ultrazohm/uz_per_skai3_lv_48v_410a/Dokumentation/IMSA-9890S-xxZ925(Z26-GT2).pdf

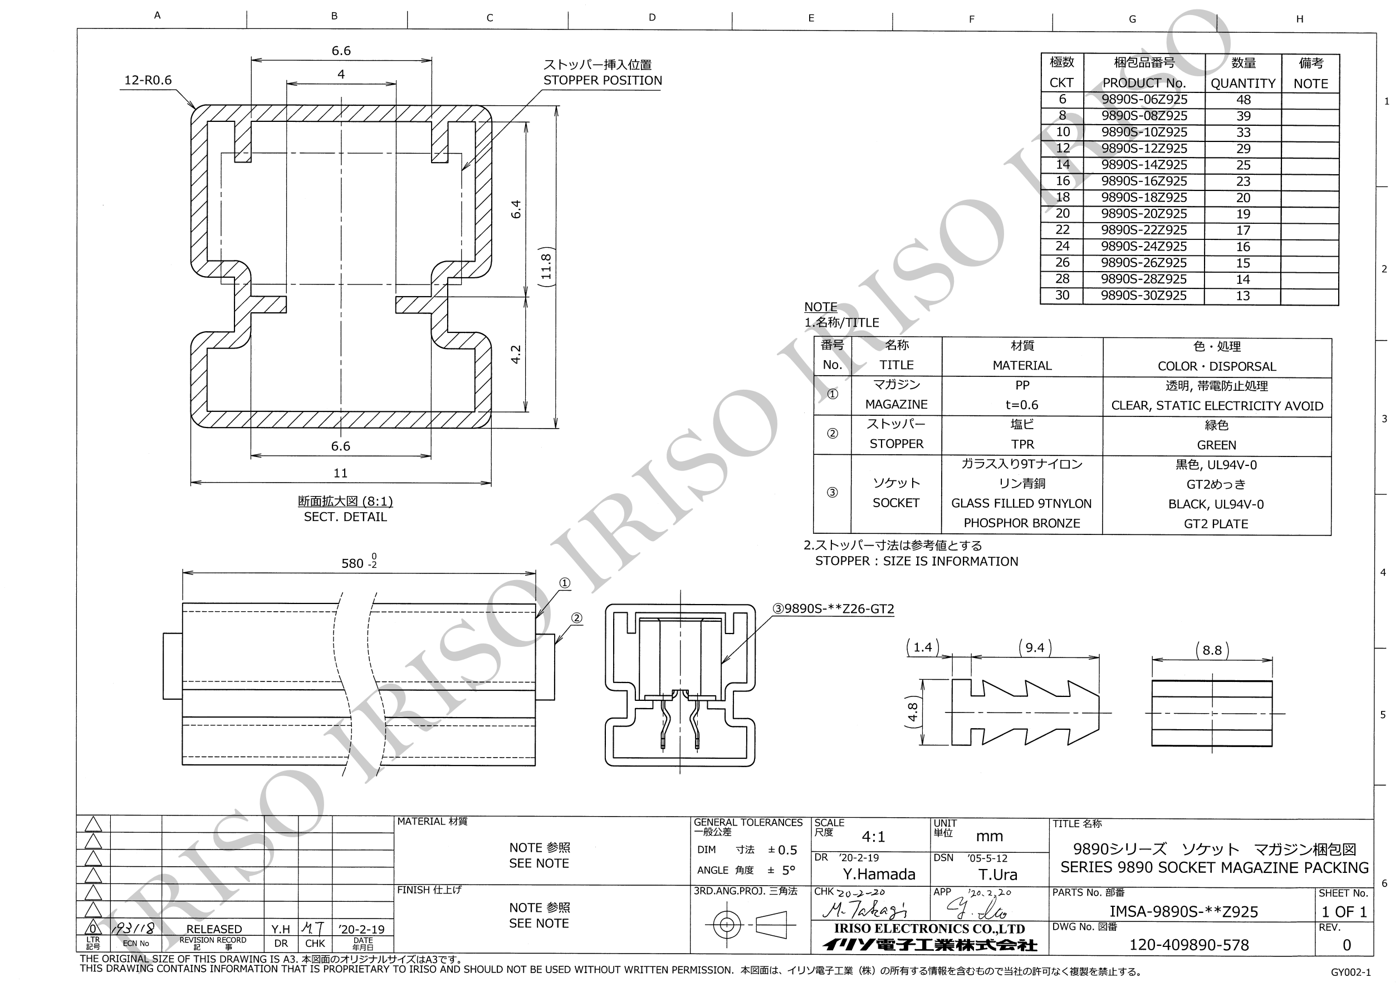
[picture p1: page 1]

IRISO IRISO IRISO IRISO IRISO

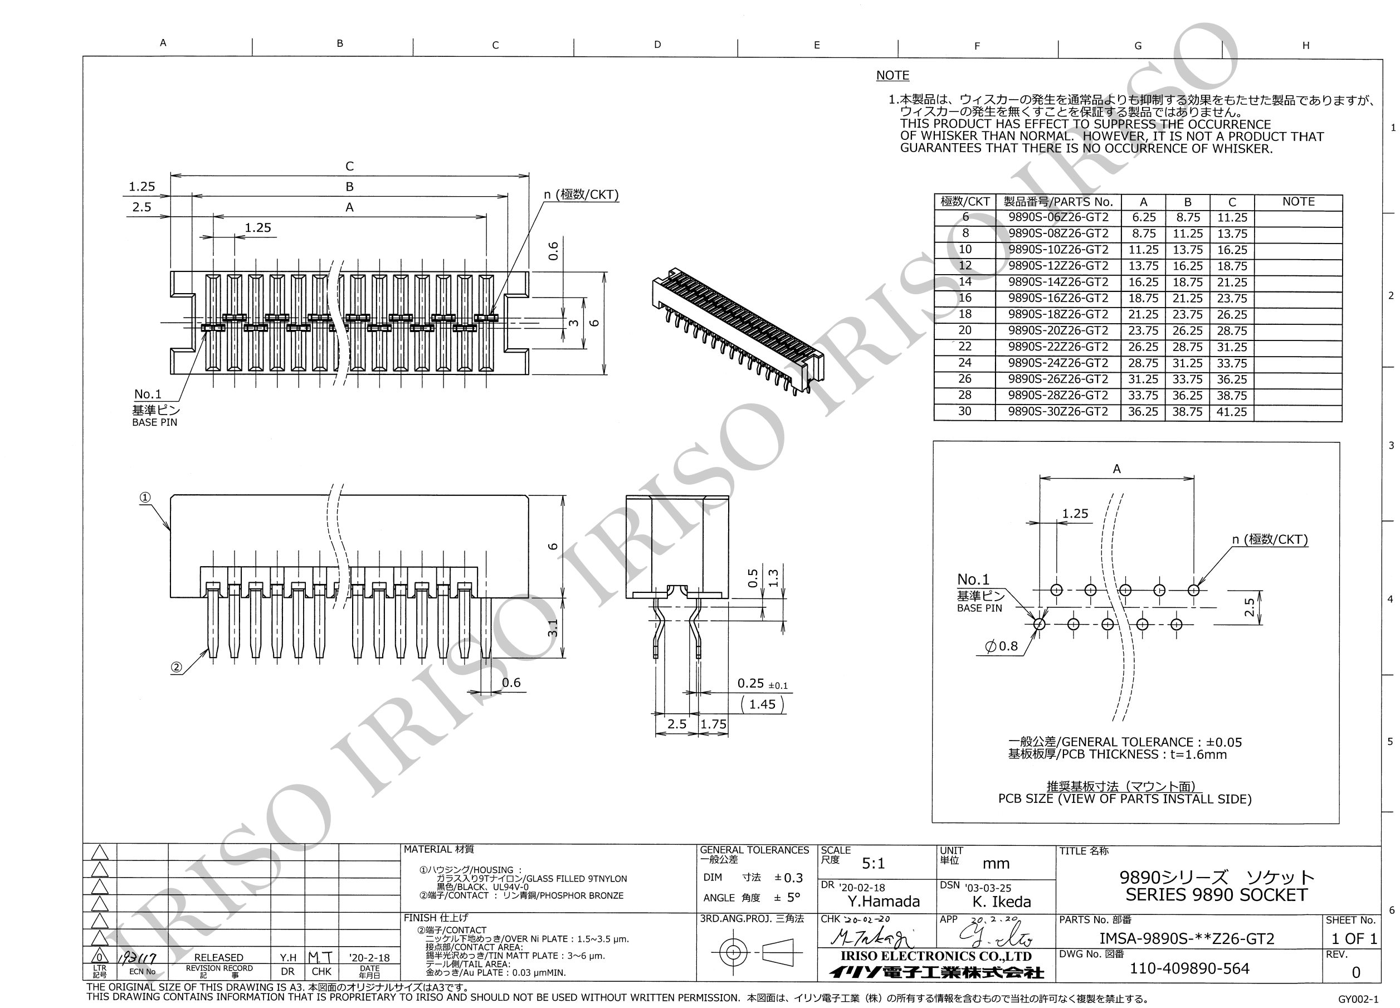
[picture p2: page 2]

IRISO IRISO IRISO IRISO IRISO
