ultrazohm/uz_per_skai3_lv_48v_410a/Altium/Project Outputs for UZ_PER_SKAI3_LV_48V_410A/Rev01/BOM/BOM_JLC-UZ_PER_SKAI3_LV_48V_410A(NoTerminationsFitted).xlsx

Quantity | Comment | Designator | Manufacturer | Value | Description | Footprint | Voltage | Dielectric | Manufacturer Part Number | LCSC Part Number
25 | 0.1 µF | C1, C2, C6, C8, C10, C11, C12, C13, C19, C20, C21, C22, C29A, C29B, C29C, C30A, C30B, C30C, C31A, C31B, C31C, C32A, C32B, C32C, C38 | KEMET | 0.1 µF | Capacitor 0603, 50 VDC, 0.1 µF, X7R | C_0603 |  |  | C0603X104K5RAC7411 | C14663
6 | 10 uF | C3, C4, C5, C7, C9, C41 | Samsung Electro-Mechanics | 10 uF | 50V 10uF X7R ±10% 1206 Multilayer Ceramic Capacitors MLCC - SMD/SMT ROHS | C_1206 |  |  | CL31B106KBHNNNE | C89632
1 | 100 pF | C14 | Samsung Electro-Mechanics | 100 pF | 50V 100pF C0G ±5% 0603 Multilayer Ceramic Capacitors MLCC - SMD/SMT ROHS | C_0603 |  |  | CL10C101JB8NNNC | C14858
6 | 22 µF | C15, C16, C17, C18, C39, C40 | muRata | 22 µF | Capacitor 0805, 25 VDC, 22 µF, X5R | C_0805 |  |  | GRT21BR61E226ME13L | C398931
16 | 56 pF | C23, C24, C25, C26, C33A, C33B, C33C, C34A, C34B, C34C, C35A, C35B, C35C, C36A, C36B, C36C | Samsung Electro-Mechanics | 56 pF | Capacitor 0603, 50 VDC, 56 pF, C0G | C_0603 |  |  | CL10C560JB8NNNC | C39148
4 | 12 nF | C27, C37A, C37B, C37C | Yageo | 12 nF | Capacitor 0603, 16 VDC, 12 nF, X7R | C_0603 |  |  | CC0603KRX7R7BB123 | C519427
1 | 1 µF | C28 | KEMET | 1 µF | Capacitor 1206, 50 VDC, 1 µF, X7R | C_1206 |  |  | C1206X105K5RECAUTO | C107185
4 | 150060GS84000 | D1, D2, D3, D4 | Wuerth Elektronik |  | WL-SMCW SMD Mono-color Chip LED Waterclear Green | WL-SMCW_0603 |  |  | 150060GS84000
1 | 0154.500DR | F1 | Littlefuse | 500 mA | Fuse OMNI BLOK 154 | Littlefuse_154 |  |  | 0154.500DR
2 | RJHSE3M80 | J1, J2 | Amphenol |  | CAT5, RJ45 Connector, 1 port, vertical | RJHSE3M80 |  |  | RJHSE3M80 | C3179193
1 | FCR7350B, PCB mount 4mm jack, BLACK | J3 | Cliff | PCB mount 4mm jack, Black FCR7350B, 1000V, 24A | FCR7350B, 1000V, 24A, BLACK | FCR7350 |  |  | FCR7350B | C7437327
1 | FCR7350R, PCB mount 4mm jack, RED | J4 | Cliff | PCB mount 4mm jack, Red FCR7350R, 1000V, 24A | FCR7350B, 1000V, 24A, RED | FCR7350 |  |  | FCR7350R | C7437326
4 | LQM31PN4R7M00L | L1, L2, L3, L4 | Murata | 4.7 uH | Power Inductors - SMD 4.7 UH 20% | IND 1206_3216 |  |  | LQM31PN4R7M00L | C162588
8 | LQM18DN6R8M70L | L5, L6, L7A, L7B, L7C, L8A, L8B, L8C | Murata | 6.8uH | 6.8µH, 120mA, 0603, 740mOhm, 20% | INDC1608X95N |  |  | LQM18DN6R8M70L | C1881372
10 | 0R | R1, R2, R30, R42, R43, R44, R45, R46, R47, R48 | YAGEO | 0R | SMD resistor E24 series | RES 0603_1608 |  |  | RC0603JR-070RL | C21189
1 | 18k | R11 | KOA Speer | 18k | SMD resistor E24 series | RES 0603_1608 |  |  | RK73B1JTTD183J | C171726
2 | 10k | R12, R17 | TE Connectivity | 10k | SMD resistor 0.1%, 10ppm | RES 0603_1608 |  |  | RQ73C1J10KBTD | C95204
2 | 305k | R13, R14 | KOA Speer | 305k | SMD resistor 0.1% | RES 0603_1608 |  |  | RN73R1JTTD3053B25 | C2507039
1 | 3k9 | R15 | YAGEO | 3k9 | SMD resistor E24 series | RES 0603_1608 |  |  | RT0603FRE073K9L | C863790
1 | 2k49 | R16 | Yageo | 2k49 | SMD resistor 1% | RES 0603_1608 |  |  | RC0603FR-072K49L | C108190
16 | 49R9 | R18, R19, R20, R21, R31A, R31B, R31C, R32A, R32B, R32C, R33A, R33B, R33C, R34A, R34B, R34C | KOA Speer | 49R9 | SMD resistor 1% | RES 0603_1608 |  |  | RK73H1JTTD49R9F | C160046
10 | 1k | R22, R23, R26, R27, R39A, R39B, R39C, R40A, R40B, R40C | IRC / TT Electronics | 1k | SMD resistor 0.1% | RES 0603_1608 |  |  | PCF-W0603LF-03-1001-B-P-LT | C110776
12 | 12.3k | R24, R25, R28, R37A, R37B, R37C, R38A, R38B, R38C, R41A, R41B, R41C | YAGEO | 12.3k | SMD resistor E24 series 12 kOhms 100mW 0603 1% | RES 0603_1608 |  |  | RT0603BRD0712K3L | C861101
9 | 5.05k | R29, R35A, R35B, R35C, R36A, R36B, R36C, R49, R50 | Vishay | 5.05k | SMD resistor 0.1% | RES 0603_1608 |  |  | TNPW06035K05BEEA | C1693738
1 | Serial # | Serial | PCB Manufacturer |  | Field to put in a serial number | SERIAL |  |  | Serial Number
2 | DS34LV86TM/NOPB | U1, U2 | Texas Instruments |  | 3V Enhanced CMOS Quad Differential Line Receiver, 16-pin Narrow SOIC, Pb-Free | TI_D-R-PDSO-G16_N |  |  | DS34LV86TM/NOPB | C181570
1 | AP63205WU-7 | U3 | Diodes Incorporate |  | Switching Voltage Regulators DCDC Conv HV Buck TSOT26 T&R 3K | TSOT26-6 |  |  | AP63205WU-7
1 | AP63200WU-7 | U4 | Diodes Incorporate |  | Switching Voltage Regulators DCDC Conv HV Buck TSOT26 T&R 3K | TSOT26-6 |  |  | AP63200WU-7
1 | AP63203WU-7 | U5 | Diodes Incorporate |  | Switching Voltage Regulators DCDC Conv HV Buck TSOT26 T&R 3K | TSOT26-6 |  |  | AP63203WU-7 | C780769
8 | ADA4940-1ARZ-R7 | U6, U7, U8A, U8B, U8C, U9A, U9B, U9C | Analog Devices |  | Fully Differential Amplifier, Ultralow-Power,Low Distortion, 260-MHz | SOT127P600X175-8N |  |  | ADA4940-1ARZ-R7 | C730049
1 | DS26C31TMX/NOPB | U10 | Texas Instruments |  | CMOS Quad Tri-State Differential Line Drivers, 16-pin Narrow SOIC, Pb-Free | TI_D-R-PDSO-G16_N |  |  | DS26C31TMX/NOPB | C132085
1 | IPL1-115-01-L-D-K | X1 | SAMTEC |  | 2.54 mm Double Row Terminal Assembly | IPL1-115-01-YYY-D-K |  |  | IPL1-115-01-L-D-K
2 | IMSA-9890S-20K-GT2 | X21, X22 | IRISO |  | Board to Board Connector | IMSA-9890S-20Z924 |  |  | IMSA-9890S-20K-GT2
