ultrazohm/uz_per_skai3_lv_48v_410a/Dokumentation/9890S-20K.STEP

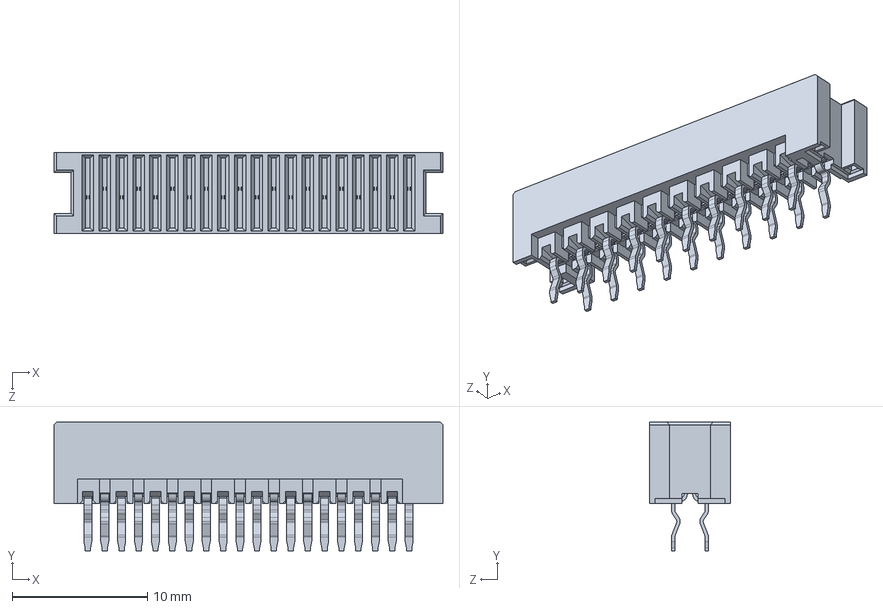
[picture p3: CAD file, 2024-04-08]
Dokumentation/9890S-20K.STEP
28.8 x 9.50 x 6.00 mm
