ultrazohm/uz_per_skai3_lv_48v_410a/Altium/Project Outputs for UZ_PER_SKAI3_LV_48V_410A/Rev01/SCH_UZ_PER_SKAI3_LV_48V_410A_Differential_Input_Rev01.PDF

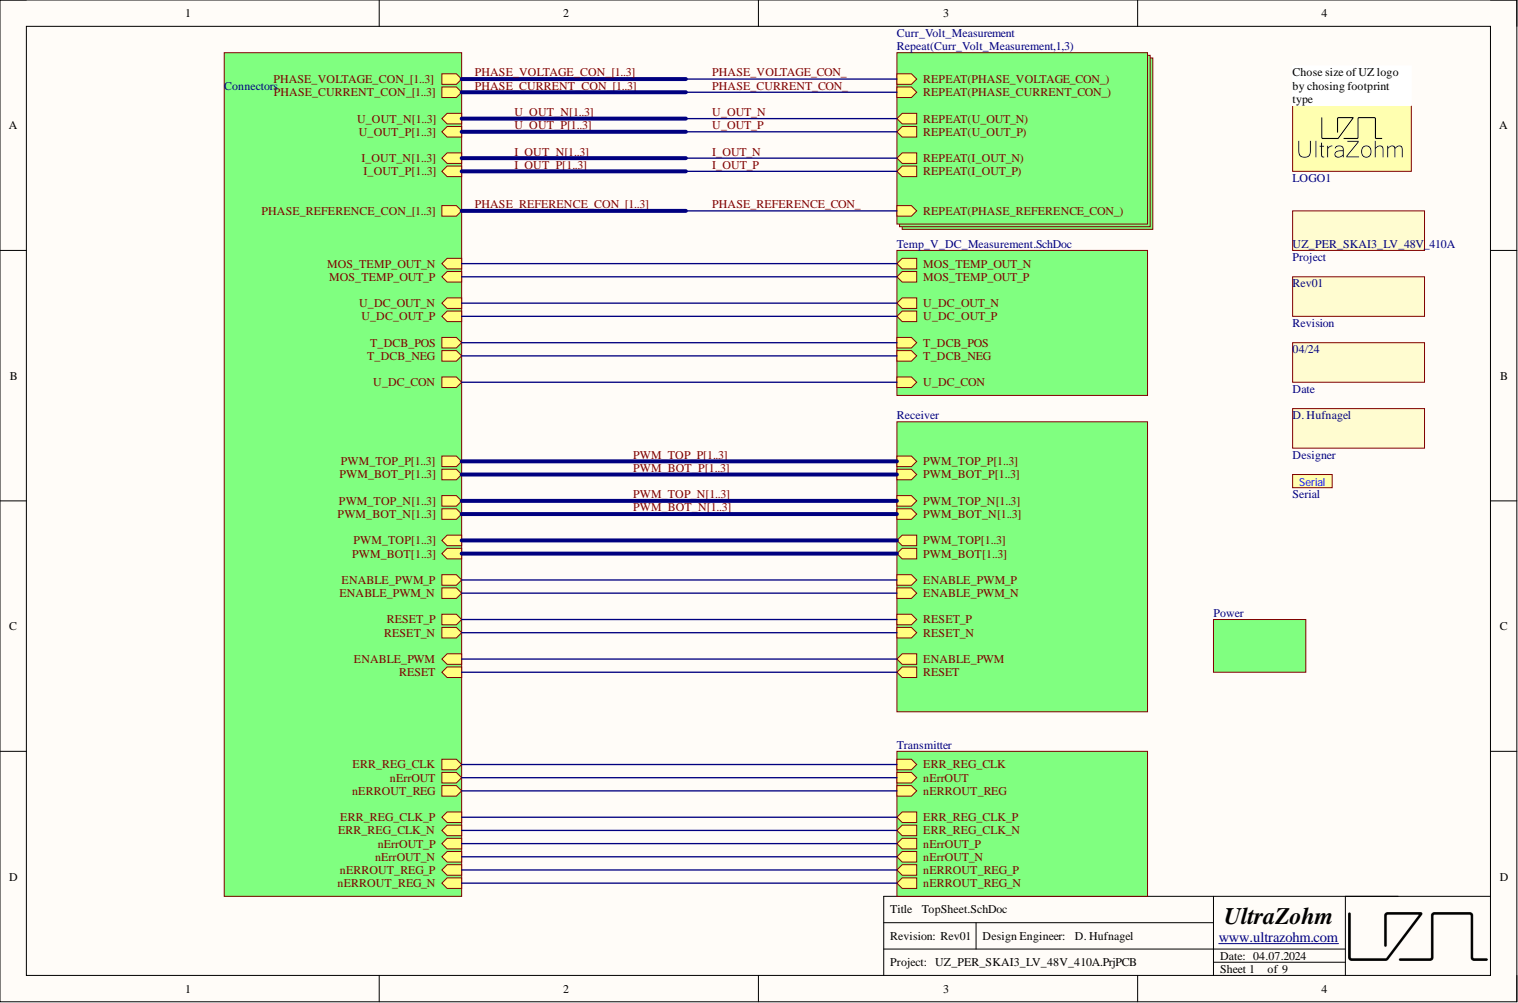
[picture p4: page 1]

Chose size of UZ logo
by chosing footprint
type

Revision:

Date: 04.07.2024

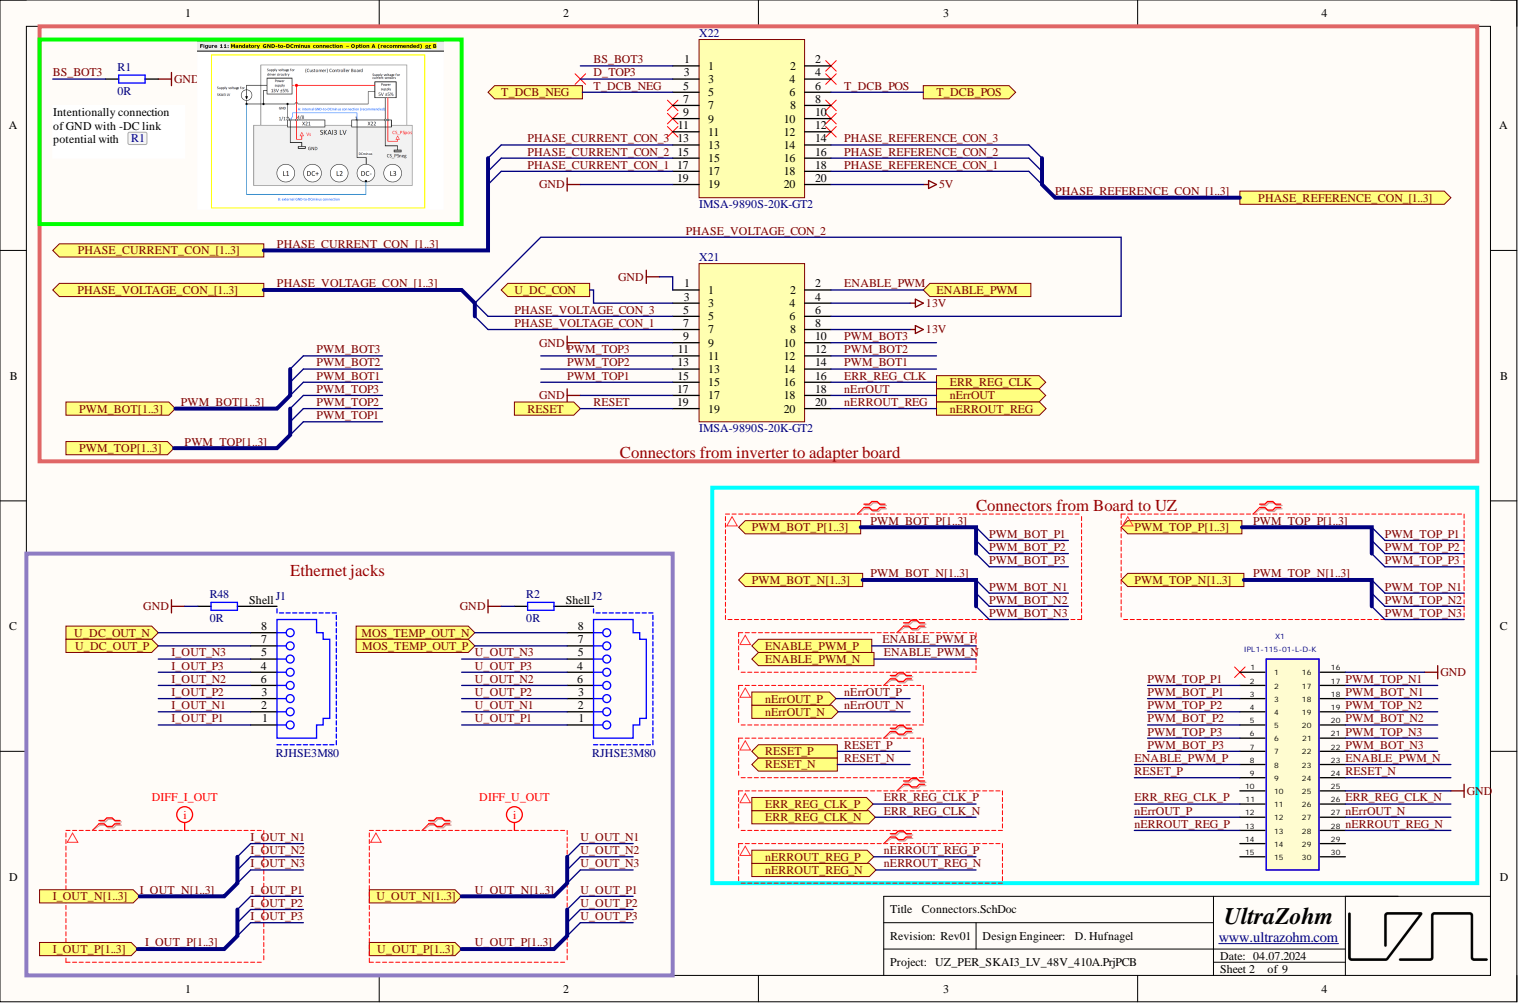
[picture p5: page 2]

Intentionally connection
of GND with -DC link
potential with R1

Connectors from inverter to adapter board

Connectors from Board to UZ

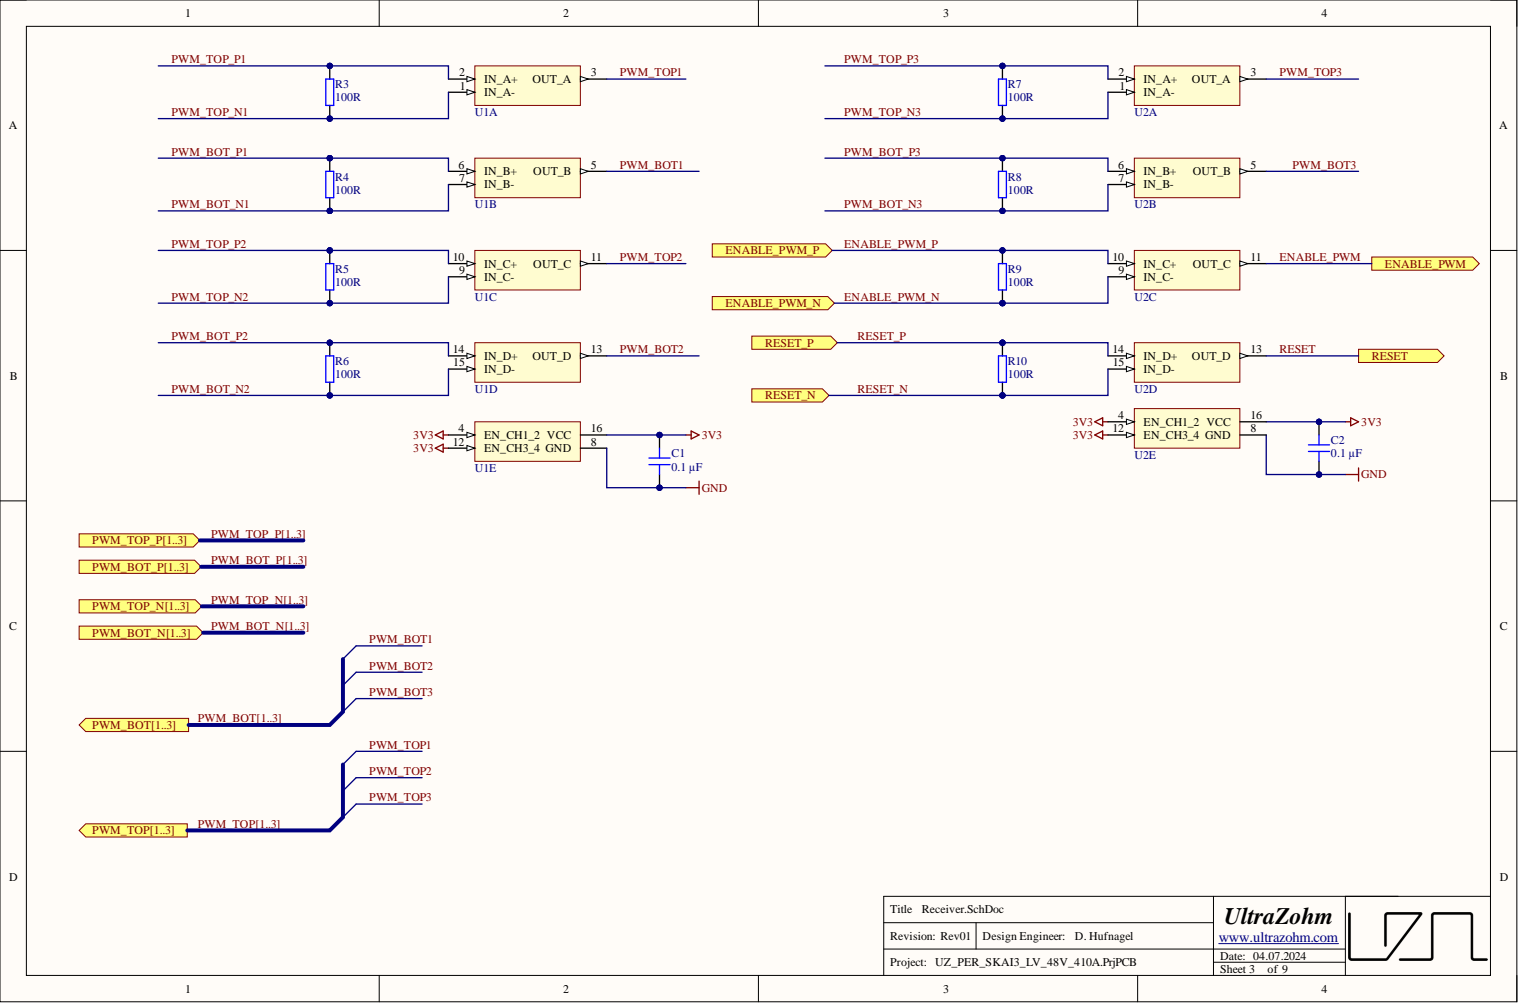
[picture p6: page 3]

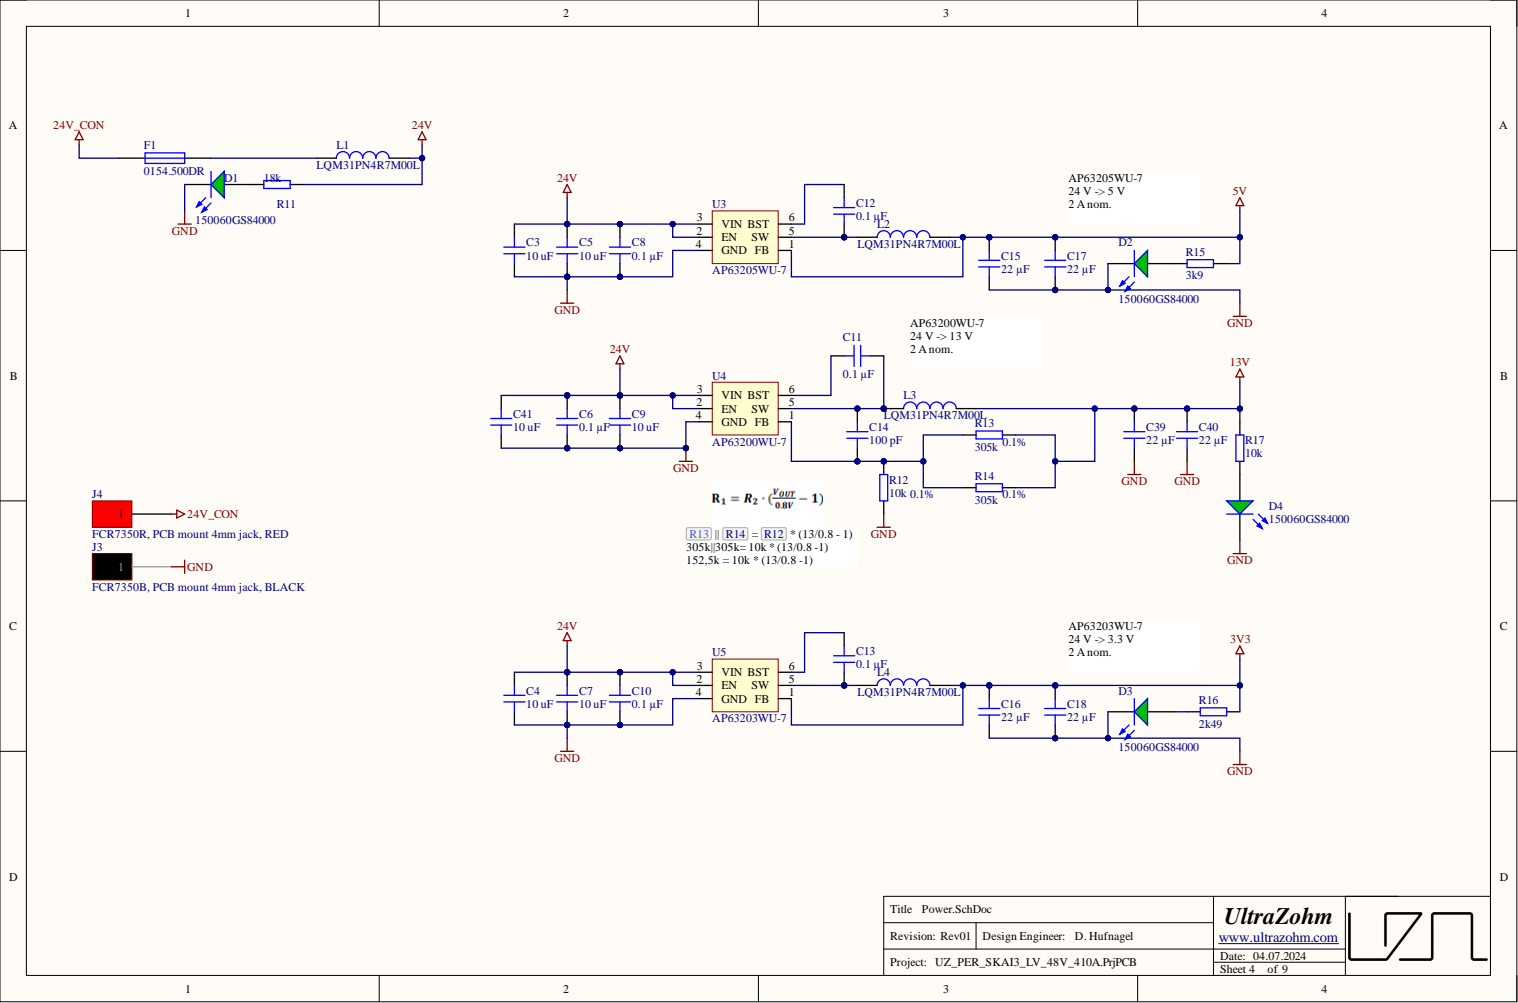
[picture p7: page 4]

Rev i s i o n :

Dat e : .

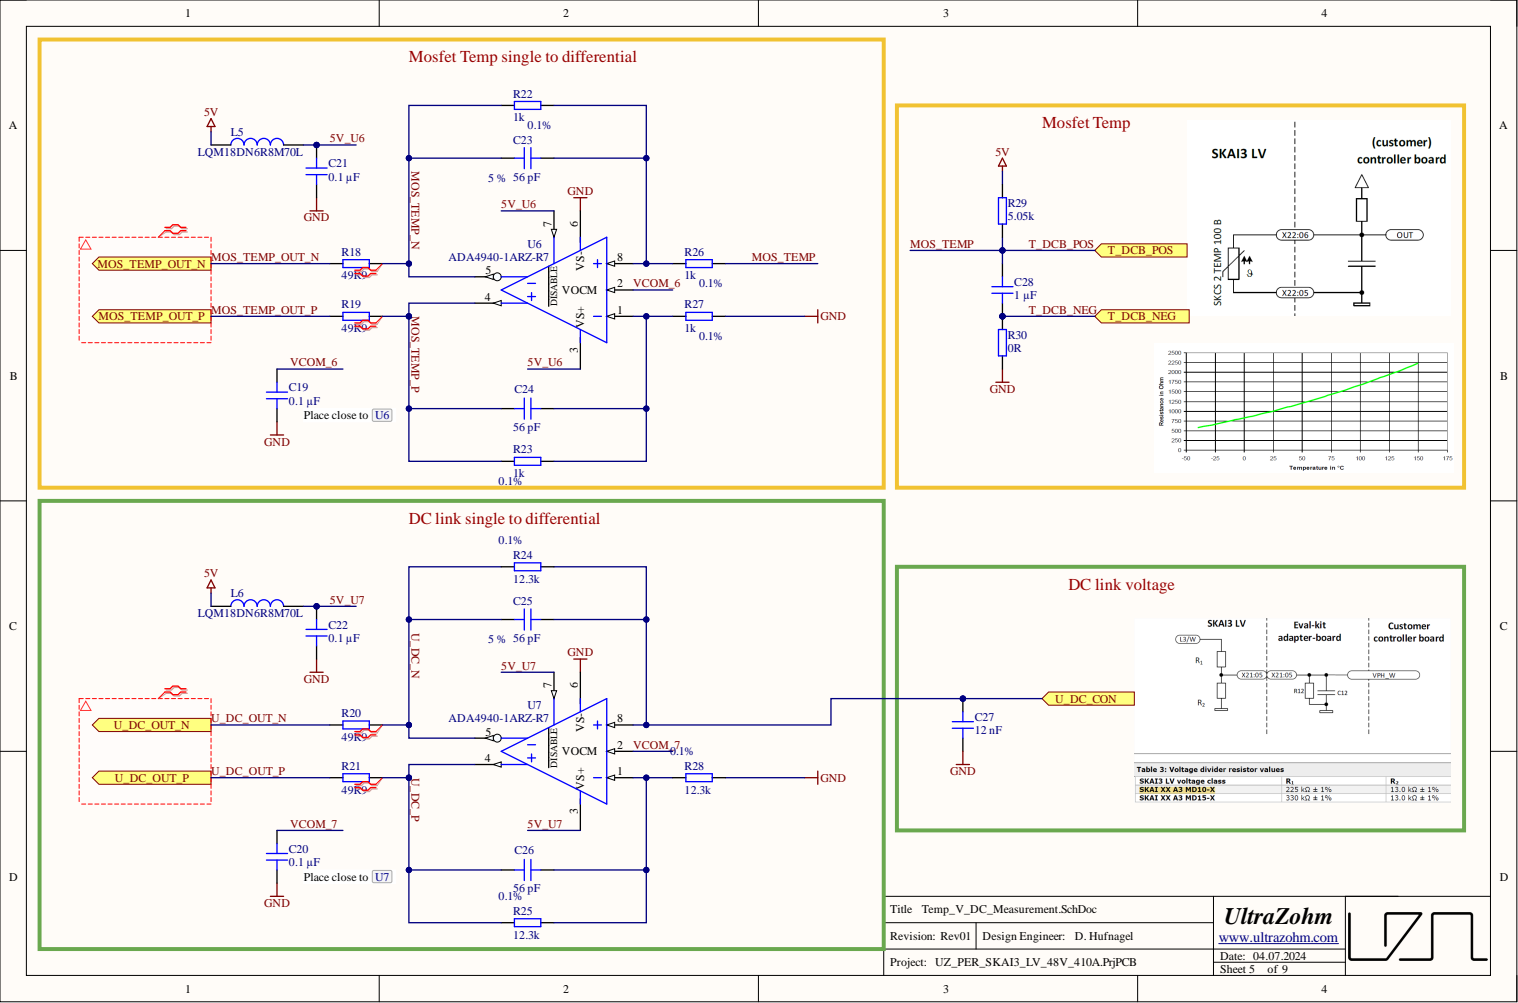
[picture p8: page 5]

Mosfet Temp single to differential

DC link single to differential

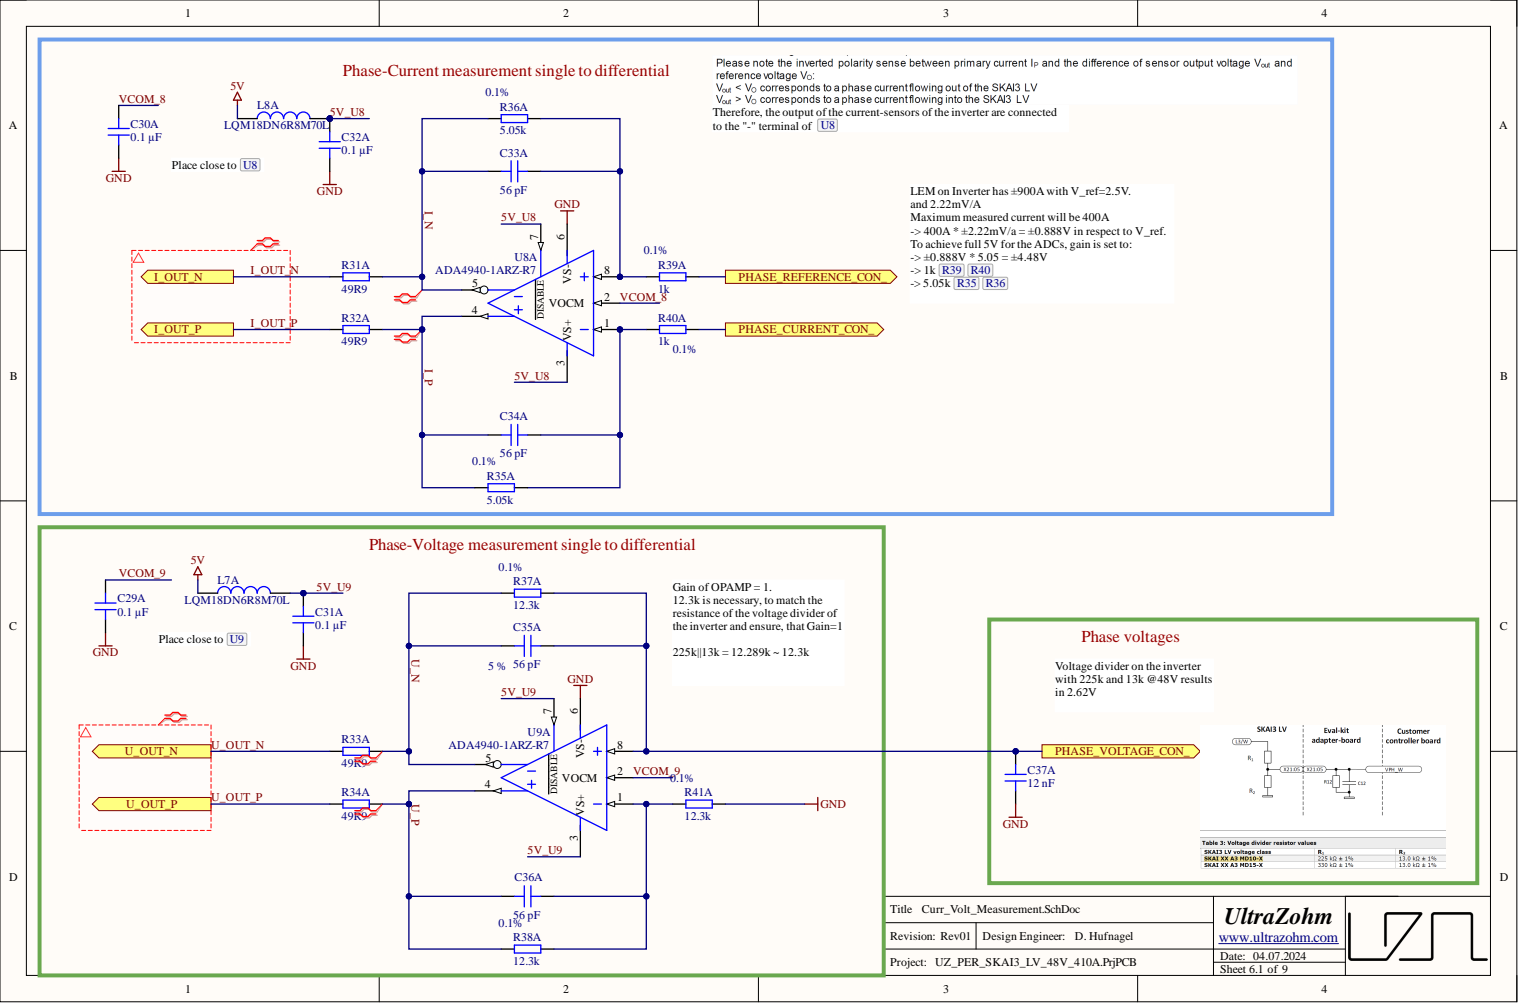
[picture p9: page 6]

Phase-Current measurementsingle to differential

Therefore, the output of the current-sensors of the inverter are connected
to the "-" terminal of U8

LEM on Inverter has ±900A with V_ref=2.5V.
and 2.22mV/A
Maximum measured current will be 400A
-> 400A * ±2.22mV/a = ±0.888V in respect to V_ref.
To achieve full 5V for the ADCs, gain is set to:

Phase-Voltage measurementsingle to differential

Gain of OPAMP = 1.
12.3k is necessary, to match the
resistance of the voltage divider of
the inverter and ensure, that Gain=1

Voltage divider on the inverter
with 225k and 13k @48V results

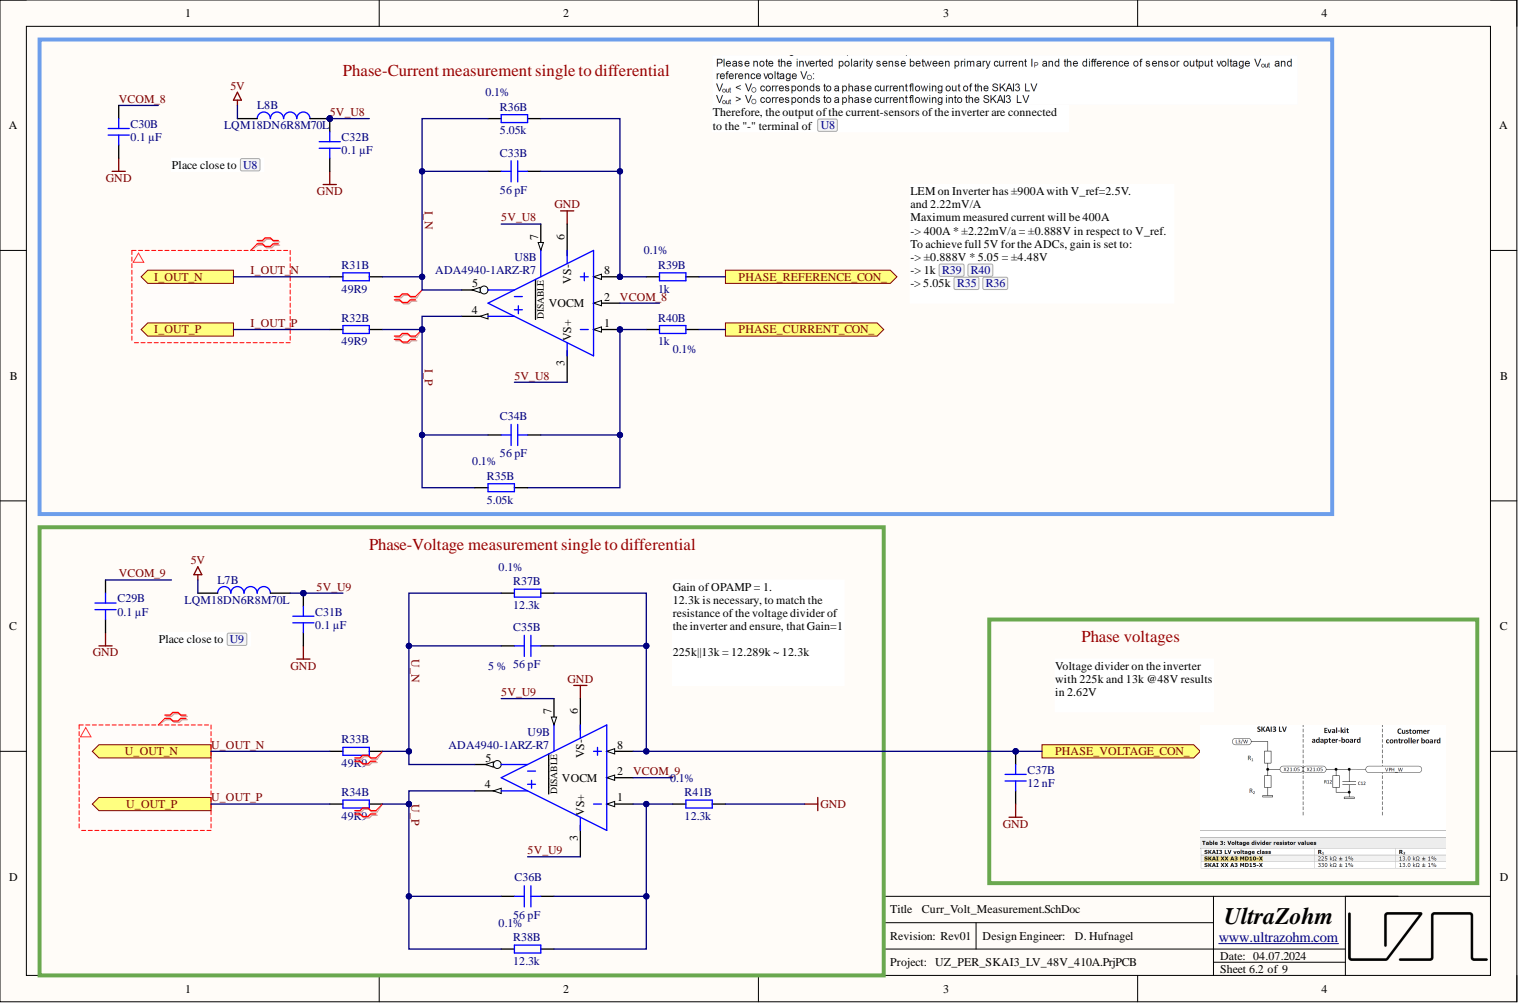
[picture p10: page 7]

Phase-Current measurementsingle to differential

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

Phase-Voltage measurementsingle to differential

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

Voltage divider on the inverter
with 225k and 13k @48V results

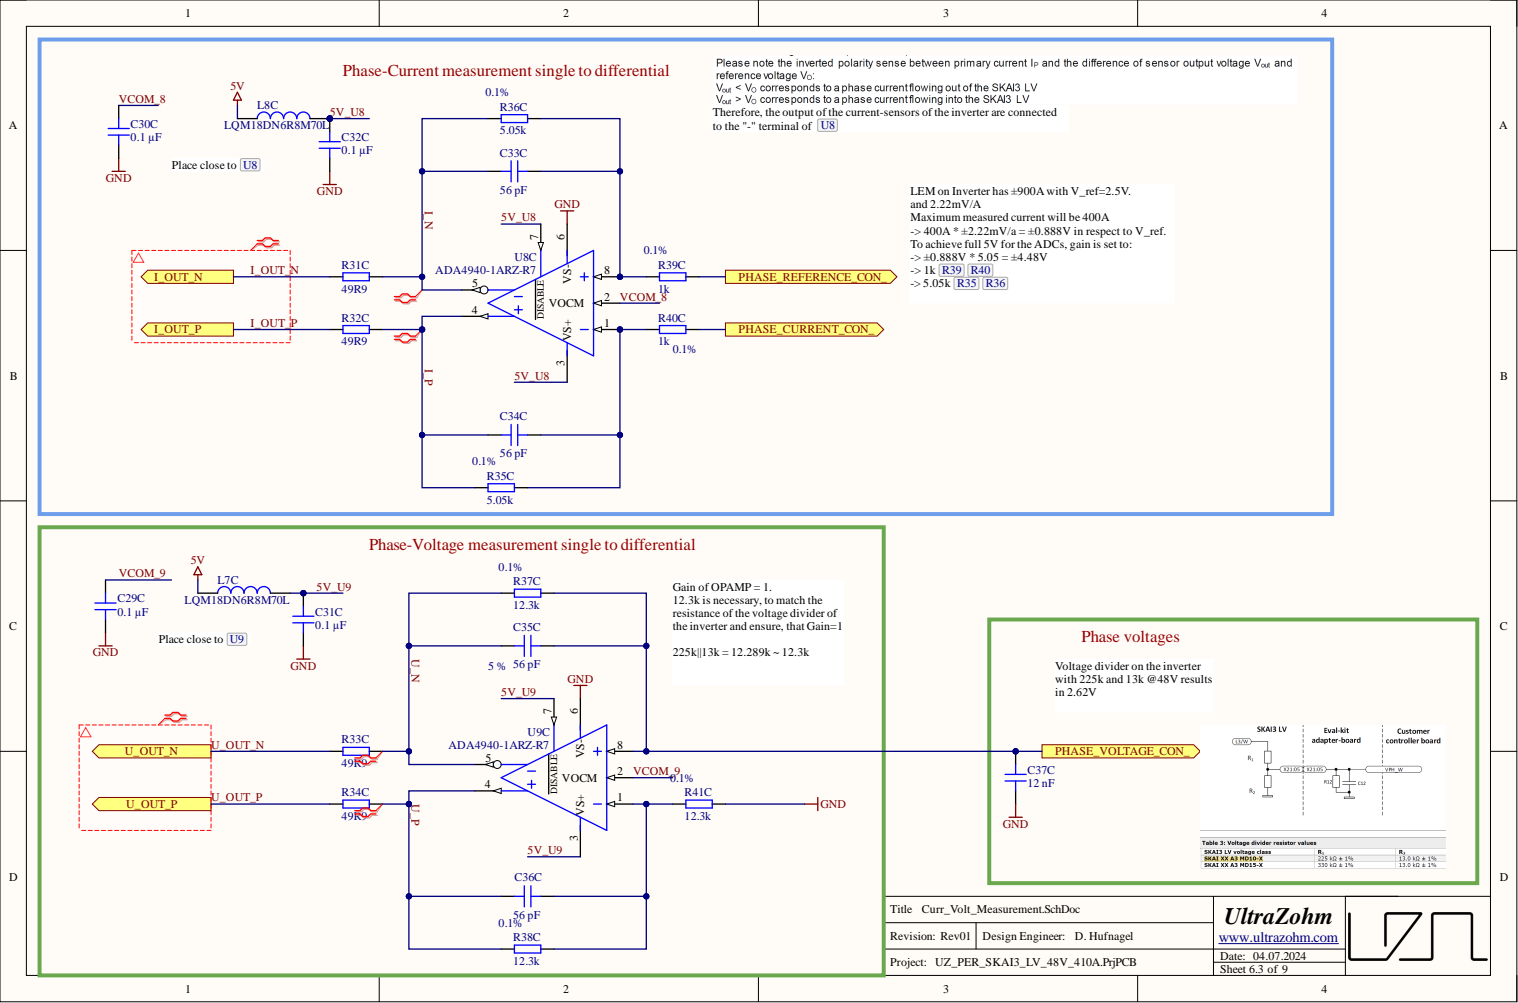
[picture p11: page 8]

Phase-Current measurementsingle to differential

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

Phase-Voltage measurementsingle to differential

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

Voltage divider on the inverter
with 225k and 13k @48V results

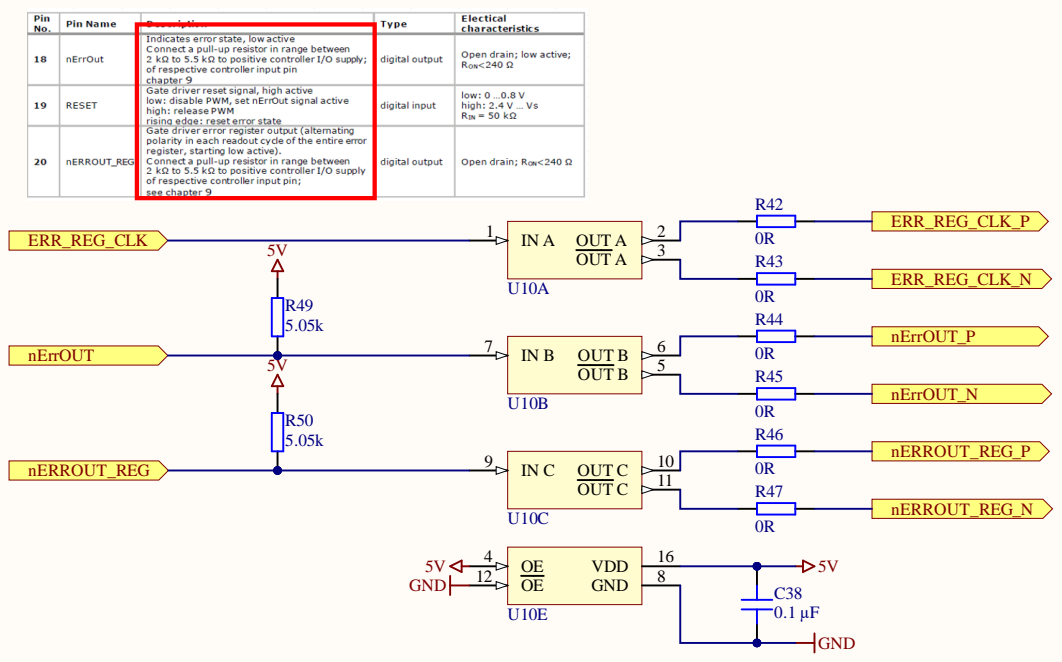
[picture p12: page 9]
