ultrazohm/uz_per_skai3_lv_48v_410a/LTSpice Simulationen/MosTemp_Meas.asc

C1: cap; 56p
C2: cap; 56p
C3: cap; 1µ
C5: cap; 100n
R1: res; 1k
R2: res; 1k
R3: res; 1k
R5: res; 1k
R7: res; R=550+85000*time
R8: res; 5.05k
R9: res; 1k
U1: ADA4940
V1: voltage; 5
V2: voltage; 5
Named nets: 0, 5v, o-, o+, R_out
.tran 20m
.ac dec 20m 10 100k
