ultrazohm/uz_per_skai3_lv_48v_410a/LTSpice Simulationen/PhaseVoltage_Meas.asc

C1: cap; 56p
C2: cap; 56p
C3: cap; 12n
C5: cap; 100n
R1: res; 12.3k
R3: res; 12.3k
R4: res; 13k
R5: res; 12.3k
R8: res; 225k
R9: res; 1k
U1: ADA4940
V1: voltage; 5
V2: voltage; SINE(24 24 50)
Named nets: 0, 5v, o-, o+
.tran 20m
.ac dec 20m 10 100k
