ultrazohm/uz_per_skai3_lv_48v_410a/(list of files, drawings)

Other design files:
Altium/Connectors.SchDoc
Altium/Curr_Volt_Measurement.SchDoc
Altium/Power.SchDoc
Altium/Receiver.SchDoc
Altium/Temp_V_DC_Measurement.SchDoc
Altium/TopSheet.SchDoc
Altium/Transmitter.SchDoc
Altium/UZ_D_Template.PrjPCB
Altium/UZ_PER_SKAI3_LV_48V_410A.PcbDoc
Altium/UZ_PER_SKAI3_LV_48V_410A.PrjPCB
