ultrazohm/uz_per_skai3_lv_48v_410a/(commit log)

2024-03-25 Adds some documentation
    [Adapterplatine_PinOut.xlsx]
2024-03-25 Adds uz_template files
    [DigitalCarrierJack.SchDoc, TopSheet.SchDoc, UZ_D_Template.PcbDoc, UZ_D_Template.PrjPCB]
2024-03-25 Project file for previous commit
    [UZ_D_Template.PrjPCB]
2024-03-25 Renames Project files
    [UZ_D_Template.PcbDoc, UZ_PER_SKAI3_LV_48V_410A.PcbDoc, UZ_PER_SKAI3_LV_48V_410A.PrjPCB]
2024-03-26 Adjusts PCB size & dimension
    [DigitalCarrierJack.SchDoc, TopSheet.SchDoc, UZ_PER_SKAI3_LV_48V_410A.PcbDoc, UZ_PER_SKAI3_LV_48V_410A.PrjPCB]
2024-03-26 Adjust Layer Stack
    [DigitalCarrierJack.SchDoc, UZ_PER_SKAI3_LV_48V_410A.PcbDoc, UZ_PER_SKAI3_LV_48V_410A.PrjPCB]
2024-04-08 Adds X21/22 connectors for connection to Inverter
    [9890S-20K.STEP, Connectors.SchDoc, TopSheet.SchDoc, UZ_PER_SKAI3_LV_48V_410A.PrjPCB]
2024-04-16 Adds 5V power supply
    [Power.SchDoc]
2024-04-16 Adds single-differential & simulation for Mosfet temp measurement
    [Temp_V_DC_Measurement.SchDoc]
2024-04-16 Adds single-differntial & simulation for DC link measurement
    [Temp_V_DC_Measurement.SchDoc]
2024-04-16 Adds 13V supply for gate driver
    [Power.SchDoc]
2024-04-16 Adds 3V3 Voltage Source
    [Power.SchDoc]
2024-04-16 Includes schematics in topsheet
    [Connectors.SchDoc, Curr_Volt_Measurement.SchDoc, Receiver.SchDoc, Temp_V_DC_Measurement.SchDoc, TopSheet.SchDoc, UZ_PER_SKAI3_LV_48V_410A.PrjPCB]
2024-04-17 Change UVW -> ABC
    [Connectors.SchDoc, Curr_Volt_Measurement.SchDoc, Temp_V_DC_Measurement.SchDoc, TopSheet.SchDoc]
2024-04-19 Adds single-differential & simulation for current/voltage measurement
    [Connectors.SchDoc, Curr_Volt_Measurement.SchDoc, Power.SchDoc, Temp_V_DC_Measurement.SchDoc, TopSheet.SchDoc, UZ_PER_SKAI3_LV_48V_410A.PrjPCB]
2024-04-19 Further work on signal connection
    [Connectors.SchDoc, Curr_Volt_Measurement.SchDoc, Receiver.SchDoc, TopSheet.SchDoc, UZ_PER_SKAI3_LV_48V_410A.PrjPCB]
2024-04-22 Finishes Receivers with terminations & Variants
    [Connectors.SchDoc, Power.SchDoc, Receiver.SchDoc, TopSheet.SchDoc]
2024-04-22 Removes wrongly placed series termination resistors
    [Receiver.SchDoc]
2024-04-23 Further work on connections & Transceiver
    [Connectors.SchDoc, Receiver.SchDoc, TopSheet.SchDoc, Transceiver.SchDoc, UZ_PER_SKAI3_LV_48V_410A.PrjPCB]
2024-04-23 Fixes some weird erros with bus signals
    [Connectors.SchDoc, Power.SchDoc, Receiver.SchDoc, Temp_V_DC_Measurement.SchDoc, TopSheet.SchDoc, UZ_PER_SKAI3_LV_48V_410A.PrjPCB]
2024-04-23 Renames 24V power net
    [Power.SchDoc]
2024-04-24 Adds some more diff-pair directives
    [Connectors.SchDoc, Power.SchDoc, UZ_PER_SKAI3_LV_48V_410A.PrjPCB]
2024-04-24 Fixes bus signals
    [Connectors.SchDoc, Curr_Volt_Measurement.SchDoc, TopSheet.SchDoc]
2024-04-24 Re-name components
    [Connectors.SchDoc, Curr_Volt_Measurement.SchDoc, Power.SchDoc, Receiver.SchDoc, Temp_V_DC_Measurement.SchDoc, Transceiver.SchDoc, UZ_PER_SKAI3_LV_48V_410A.PrjPCB]
2024-04-25 Switches some signals, replaces Ethernet Jack&Samtec with vertical ones
    [Connectors.SchDoc, Power.SchDoc, Receiver.SchDoc, TopSheet.SchDoc]
2024-04-25 Starts work on Layout
    [Connectors.SchDoc, Power.SchDoc, UZ_PER_SKAI3_LV_48V_410A.PrjPCB]
2024-04-26 Continues work on PCB placed the 5V,3V3,13V components
    [Power.SchDoc]
2024-04-29 Continues work on pcb. Some power layers added
2024-04-30 Routes single->diff OPAMP of phase voltage&currents
    [Power.SchDoc]
2024-04-30 save project
    [UZ_PER_SKAI3_LV_48V_410A.PrjPCB]
2024-04-30 Fixes some designator in names
    [TopSheet.SchDoc]
2024-05-02 Fix current measurement gain & resistors for 13V-power in schematic
    [Curr_Volt_Measurement.SchDoc, Power.SchDoc]
2024-05-02 Fixes regarding temp_measurement & comments
    [Curr_Volt_Measurement.SchDoc, Power.SchDoc, Temp_V_DC_Measurement.SchDoc]
2024-05-02 Renames file
    [Curr_Volt_Measurement.SchDoc, Transceiver.SchDoc, Transmitter.SchDoc]
2024-05-02 Reworks diff signal layout
    [TopSheet.SchDoc, Transmitter.SchDoc]
2024-05-03 Final PCB changes
    [Receiver.SchDoc, UZ_PER_SKAI3_LV_48V_410A.PrjPCB]
2024-05-03 Changes inductances
    [Power.SchDoc, UZ_PER_SKAI3_LV_48V_410A.PrjPCB]
2024-05-03 Adds BOM
    [BOM_JLC-UZ_PER_SKAI3_LV_48V_410A.xlsx, BOM_UZ_PER_SKAI3_LV_48V_410A.xlsx]
2024-05-03 Adds Gerber & drill files
    [Pick Place for UZ_PER_SKAI3_LV_48V_410A.csv, PickPlace_UZ_PER_SKAI3_LV_48V_410A_Rev01.csv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]
2024-05-03 updated bom
    [BOM_JLC-UZ_PER_SKAI3_LV_48V_410A.xlsx]
2024-05-03 Fix some wrong footprints for resistor
    [Curr_Volt_Measurement.SchDoc, Temp_V_DC_Measurement.SchDoc]
2024-05-03 Updates output files
    [BOM_JLC-UZ_PER_SKAI3_LV_48V_410A.xlsx, BOM_UZ_PER_SKAI3_LV_48V_410A.xlsx, Pick Place for UZ_PER_SKAI3_LV_48V_410A.csv, PickPlace_UZ_PER_SKAI3_LV_48V_410A_Rev01.csv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]
2024-05-03 More footprint fixes
    [Curr_Volt_Measurement.SchDoc, Temp_V_DC_Measurement.SchDoc]
2024-05-03 Fix another footprint issue
    [Transmitter.SchDoc]
2024-05-03 updates output files again
    [BOM_JLC-UZ_PER_SKAI3_LV_48V_410A.xlsx, BOM_UZ_PER_SKAI3_LV_48V_410A.xlsx, Pick Place for UZ_PER_SKAI3_LV_48V_410A.csv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]
2024-05-03 Increases via hole size to min 0.3mm
    [BOM_JLC-UZ_PER_SKAI3_LV_48V_410A.xlsx, Pick Place for UZ_PER_SKAI3_LV_48V_410A.csv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]
2024-05-03 Small via fixes
    [BOM_JLC-UZ_PER_SKAI3_LV_48V_410A.xlsx, Pick Place for UZ_PER_SKAI3_LV_48V_410A.csv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]
2024-05-06 Changes to 1 GND connection at the UZ connector
    [Connectors.SchDoc]
2024-05-08 Fixes all 100nF caps to the same part
    [BOM_JLC-UZ_PER_SKAI3_LV_48V_410A.xlsx, BOM_UZ_PER_SKAI3_LV_48V_410A.xlsx, Curr_Volt_Measurement.SchDoc, Pick Place for UZ_PER_SKAI3_LV_48V_410A.csv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]
2024-07-04 Adds PDF schematic
2024-07-12 Adds hint to schematic regarding opamp gain issue with Temp measurement
    [Temp_V_DC_Measurement.SchDoc]
2024-11-12 updates geber files
    [BOM_JLC-UZ_PER_SKAI3_LV_48V_410A(NoTerminationsFitted).xlsx, BOM_JLC-UZ_PER_SKAI3_LV_48V_410A.xlsx, Pick Place for UZ_PER_SKAI3_LV_48V_410A(NoTerminationsFitted).csv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]
